rxshabN/neurobadge_project/(commit log)

2026-04-10 Add neurobadge.ino for WiFi and sensor integration
    This file initializes a WiFi connection, reads temperature and air quality data, and logs fatigue status to Firebase.
2026-04-10 added circuit diagram
